craigyjp/reSEMble-MIDI-to-CV/MIDI_to_CV.pdf

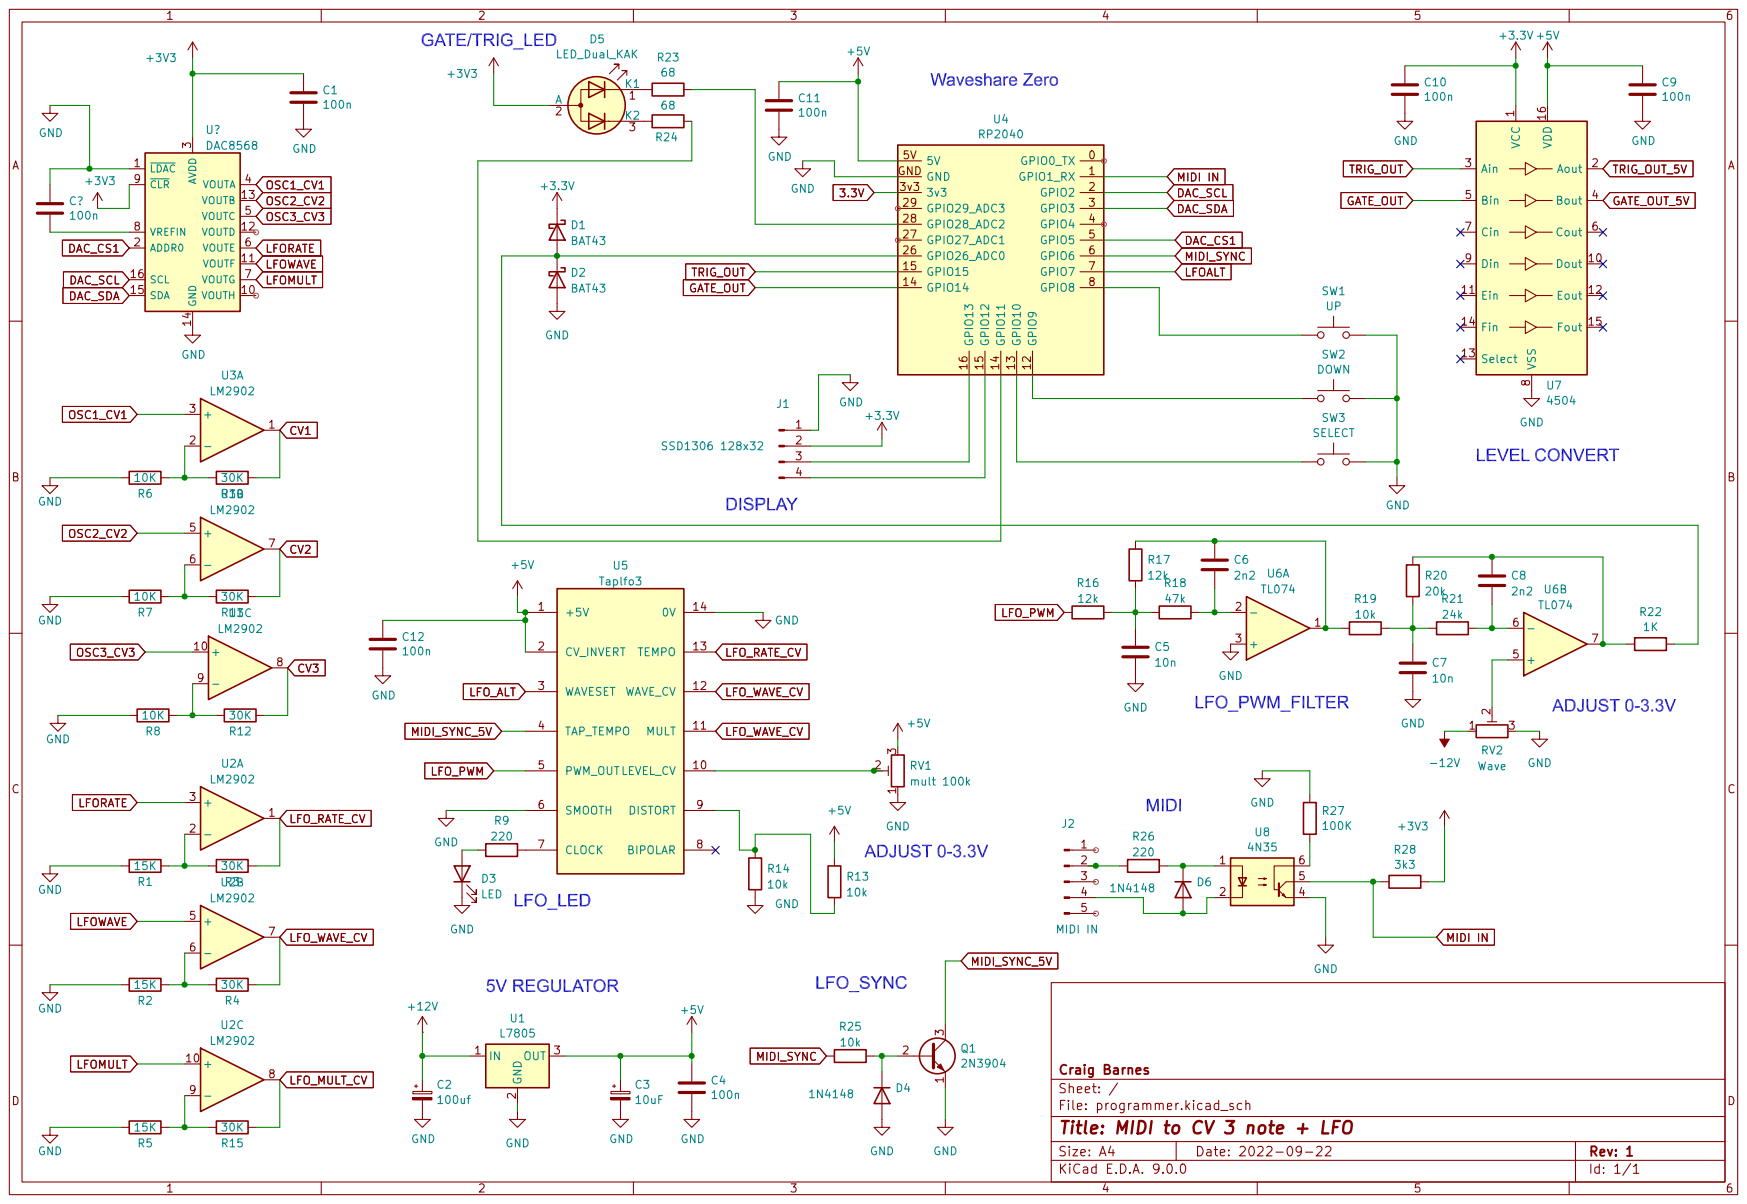
[picture p1: page 1]
