craigyjp/reSEMble-MIDI-to-CV/(commit log)

2025-02-24 Added schematics
2025-02-26 Added bicolour LED for gate/trig
2025-02-26 Fixed note priority and added gate/trigger LED
    [16bit_3_note_Zero_MIDI_CV.ino, Hardware.h, Parameters.h]
2025-02-27 Fixed all notes off
    [16bit_3_note_Zero_MIDI_CV.ino]
2025-02-28 Fixed polymode voice resetting to low value
    [16bit_3_note_Zero_MIDI_CV.ino]
2025-02-28 Fixed trigger in polymode
    [16bit_3_note_Zero_MIDI_CV.ino]
